endlos99/finalgrom99/doc/manual.html

# FinalGROM 99

The TI 99/4A FinalGROM Cartridge, or FinalGROM 99 for short, is a cartridge for the TI 99/4A home computer that allows you to run ROM and GROM cartridge images from an SD card. It succeeds the FlashROM 99 (https://endlos99.github.io/flashrom99) released in 2016.

The FinalGROM 99 Cartridge

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

Mounted in Cartridge Shell

The FinalGROM 99 is released as Open Source Hardware under the CERN OHL license (http://www.ohwr.org/projects/cernohl/wiki) and the GNU GPL license (http://www.gnu.org/licenses/gpl.html). Both hardware design files and firmware sources are available on GitHub (https://github.com/endlos99/finalgrom99).

The project homepage with detailed instructions is located at GitHub (https://endlos99.github.io/finalgrom99).

## How to Start with the FinalGROM 99

Using the FinalGROM 99 is simple and doesn't require any special hardware or software.

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

Image selection

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

## How to Prepare the FinalGROM 99

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

### Images

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

helloc.bin   <-
hellod.bin   <-  the image files
hellog.bin   <-
layout.xml
meta-inf.xml

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

Finally, many assemblers such as the xas99 cross-assembler or the xga99 GPL cross-assembler from the xdt99 tools (https://endlos99.github.io/xdt99) can generate ROM and GROM images. Files generated for Editor/Assembler Option #5 cannot be used, but they may be converted for the FinalGROM 99 plus 32K RAM expansion.

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

The FinalGROM 99 uses "non-inverted" ROM images, which is the default for images until noted otherwise by the creator. Images ending in 3 or 9 are usually inverted. If you have an inverted ROM image, you can use the Python script tools/invert.py found in the repository (https://github.com/endlos99/finalgrom99) to de-invert the image. If a single file ROM image crashes the TI 99, invert it and see if that works instead.

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

### Filenames

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

A GROM-only image is always a single file whose filename ends in G:

hellog.bin

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

helloc.bin
hellod.bin   (optional)
hellog.bin

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

The split file format has been used for virtually all cartridge dumps for several decades now.

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

In summary, don't rename cartridge dumps. GROM filenames must not exceed 8 characters AND must end in G. ROM filename must have more than 8 characters OR must not end in D or G.

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

### SD Cards

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

### Tools

The tools/ folder in the repository (https://github.com/endlos99/finalgrom99) contains some Python scripts that help you to manage your images.

The showcart.py tool will list the menu entries for the image files given.

Example: showcart.py images/*.bin

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

Example: invert.py image.bin

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

Examples: pad.py image.bin pad.py largeimage.bin 65536

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

Example: mkea5cart.py program1 theprogram.bin "THE PROGRAM"

## How to Use the FinalGROM 99

This section details the operation of the FinalGROM 99 and explains all of its features.

### Normal Operation

The FinalGROM 99 is always in one of two modes: menu mode or image mode.

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

It is not possible to damage the FinalGROM 99 by incorrect menu or image operation.

### Help Viewer

The FinalGROM 99 allows you to view image help texts stored on the SD card.

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

To return to the FinalGROM 99 menu, press Q to quit the help viewer.

If no help text is found, you'll return immediately to the FinalGROM menu.

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

The first line of your help file may contain a hexadecimal color code for the text

    >1E

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

### Advanced Modes

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

aorg >6000
data >aa01
byte >00, 'R'  ; activate RAM mode

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

### Compatibility

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

Please refer to the troubleshooting section for a list of programs with known issues.

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

## How to Develop for the FinalGROM 99

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

### Advanced Modes

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

move 10, g@data, g@>7800

and alike would be the only way to write to GRAM.

### Reloading

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

The repository (https://github.com/endlos99/finalgrom99) contains sample code lib/reload_example.a99 and lib/gload_example.gpl that may serve developers as a blueprint for reloading. The syntax requires the xas99 or xga99 assemblers (https://endlos99.github.io/xdt99), but the code is easily adapted to other assemblers as well.

### Dumping

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

The repository (https://github.com/endlos99/finalgrom99) contains sample code lib/dump_example.a99 and lib/gdump_example.gpl that may serve developers as a blueprint for dumping. The syntax requires the xas99 and xga99 assemblers (https://endlos99.github.io/xdt99), but the code is easily adapted to other assemblers as well.

## How the FinalGROM 99 Works

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

The microcontroller uses a modified version of the Petit FatFs (http://elm-chan.org/fsw/ff/00index_p.html) library to make sense of the FAT16/FAT32 filesystems used by SD cards. It also uses a port of the Xilinx XSVF player described in Application Note 058 (http://www.xilinx.com/support/documentation/application_notes/xapp058.pdf).

## How to Update the FinalGROM 99

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

#U1  (o)........(o).........(o)........(o)........(o)........(o) ...

indicates a bad SD card reader, a bad SD card, or the wrong filesystem,

#U2  (o).(o)........(o).(o).........(o).(o)........(o).(o)...... ...

indicates a missing or corrupt update file.

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

### Update 1.1

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

Download 1.1

### Update 1.2

Issues: - None

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

Download 1.2

### Update 1.3

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

This update fixes this issue, while still auto-loading single images with only subprograms.

Download 1.3

## Troubleshooting the FinalGROM 99

If you're in doubt if your FinalGROM 99 is working correctly, run the cartridge tests in folder images/tests/ in the repository (https://github.com/endlos99/finalgrom99). All tests run endlessly and will show errors as ERROR xxxx yyyy at the bottom of the screen. The hex value xxxx is the expected word and yyyy is the actual word read.

#### The LED blinks.

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

#1  (o)........(o).........(o)........(o)........(o)........(o) ...

indicates a bad SD card reader, a bad SD card, or the wrong filesystem,

#2  (o).(o)........(o).(o).........(o).(o)........(o).(o)...... ...

indicates the root folder cannot be read, or the image cannot be dumped,

#3  (o).(o).(o)........(o).(o).(o).........(o).(o).(o)......... ...

indicates a corrupt image, a corrupt help file, or an error during dumping.

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

#### The TI 99 title screen won't show.

The LED lights for some time, but the TI title screen won't show.

The FinalGROM 99 is active, but it interferes with the console GROMs.

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

#### There is no FinalGROM 99 entry.

The TI 99 starts normally, but the menu shows only TI BASIC.

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

#### Some menu entry is missing.

The menu entry of some image, in particular some educational title, is missing.

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

Check the filename of your image, and look for that filename in the image browser.

#### The image browser shows weird entries.

The image browser shows meaningless entries such as DEUTSCH or ITALIANO.

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

If you don't know which image is producing these rogue entries, you can use the tools/showcart.py script in the repository (https://github.com/endlos99/finalgrom99) like this:

$ showcart.py phm3112C.BIN phm3112G.BIN

to get the list of entries for the specified list of programs:

phm3112C.BIN: **MISSING >AA**
phm3112G.BIN: PARSEC

#### The image browser crashes.

The images browser shows weird characters and does no longer react to key presses.

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

#### Some program crashes.

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

#### Some program doesn't work properly.

Some functionality of the program doesn't work as expected.

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

#### RAM/GRAM cannot be written to.

The program cannot write to the RAM banks or the GRAM banks.

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

#### Mini Memory won't work.

The Mini Memory won't save assembly programs.

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

#### Programs with known issues.

These programs are know to have minor or major flaws when run on the FinalGROM 99:

- As of this writing, no issues or glitches are known.

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

## Where to Get the FinalGROM 99

The GitHub repository (https://github.com/endlos99/finalgrom99) contains all hardware design files and software sources required to build the FinalGROM 99 by yourself.

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

## About the Project

The TI 99/4A FinalGROM Cartridge is Open Source Hardware released under the CERN OHL license (http://www.ohwr.org/projects/cernohl/wiki), in the hope that TI 99 enthusiasts may find it useful. Software components are released under the GNU GPL license (http://www.gnu.org/licenses/gpl.html).

The hardware was designed with the open source electronics design automation suite KiCad (http://kicad-pcb.org). The microcontroller code uses a modified version of the Petit FatFs (http://elm-chan.org/fsw/ff/00index_p.html) library.

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

Contributions to both hardware and software are welcome. Please email feedback, support questions, inquiries for parts, and bug reports to the developer at r@0x01.de. Discussions about the FinalGROM 99 happen over at AtariAge (http://atariage.com/forums/topic/260917-the-finalgrom-99).
