endlos99/finalgrom99/(threads)

Thread 1 (2019-01-08):

4A DOS w/Auto-start+CHARA1 companion GROM doesn't load GROM image

jedimatt42, 2019-01-08:
Given a GROM file that has a header of:

0xAA00 0x0000 0x6010 0x0000
where 0x6010 is a powerup routine in the GROM.  and a ROM image with a standard ROM header... such as that of 4A DOS, with one or two program entries...
FG99 does not create a menu entry for the GROM even though 4A's boot rom qualifies it as a valid GROM header with a powerup routine.  FG99 does create a menu entry for the ROM file...

When loading the file from a menu entry, it looks like if it starts with a GROM, then it will load companion ROM files C and D, but if it starts with a ROM, it never looks for a companion G.BIN to load.

I was able to work around this by adding a menu entry to my GROM so it would become the 'master' file for the entry.

-M@

endlos99, 2019-01-15:
Thanks for reporting this issue!

As you said, if no entries are found in the `G` file, the FinalGROM ignores this file entirely.  This holds true for any file.  But there's some logic that when an entry of a file that ends in `G` is selected, the files `G`, `C`, and `D` are loaded, if they exist.  If the entry is in a `C` file, then only `C` and `D` are loaded, since there is no `G` file in general.

The solution to this problem would be to try to load a `G` file when selecting an entry in a `C` file.  This seems easy enough, but the problem is that for every "open" in the code, the microcontroller has to scan the entire directory for a file with the requested name.  This time is noticeable if the directory is near its limit of 171 entries -- I've tested it.

Now if this were a common pattern, I could still add the extra load as there would be a real benefit.  In this case, however, 4A DOS seems to be the only program known to be affected, and there is a known workaround.

So unless this problem rises again, I'll keep the current logic.

Closed 2019-01-15.

Thread 5 (2023-08-04):

Sub folders not loading

ghhann, 2023-08-04:
Weird issue. On a beige ti.  I insert the finalgrom and see it as 2 on the menu. I press 2 and get your submenus a b c and so forth.  When I press any submenu. I get a weird screen blip and then no items shown.

I redid the sd card and not working.  I can access the directories on my PC.

Any place to start troubleshooting?

Best

ghhann, 2023-08-04:
Never mind appearantly I have a qi motherboard.

ghhann, 2023-08-04:
Thank you

ghhann, 2023-08-08:
Thanks very much appreciated your hard work and efforts to this project Sent via the Samsung Galaxy A52 5G, an AT&T 5G smartphone
-------- Original message --------From: Ralph Benzinger ***@***.***> Date: 8/8/23  11:08 AM  (GMT-05:00) To: endlos99/finalgrom99 ***@***.***> Cc: ghhann ***@***.***>, Author ***@***.***> Subject: Re: [endlos99/finalgrom99] Sub folders not loading (Issue #5)
There is a firmware for QI machines available, but I've just realized that it isn't published in the repo.  Let me find it, then I can include it here as well.

—Reply to this email directly, view it on GitHub, or unsubscribe.You are receiving this because you authored the thread.Message ID: ***@***.***>

ghhann, 2023-08-11:
Not to bother you but I was wondering if you found the updated firmware for the qi models.I actually just finished another ti99/4a so I have a beige qi model that is now clean and functioning and a black/chrome model which is also clean and functional.Been enjoying seeing what these can do since I never had one in the 80's.All my best and thank you for your help and work and efforts in developing these expansion cartridges....Dr Glenn Hann PhD Sent via the Samsung Galaxy A52 5G, an AT&T 5G smartphone
-------- Original message --------From: ghhann ***@***.***> Date: 8/8/23  11:58 AM  (GMT-05:00) To: endlos99/finalgrom99 ***@***.***>, endlos99/finalgrom99 ***@***.***> Cc: Author ***@***.***> Subject: Re: [endlos99/finalgrom99] Sub folders not loading (Issue #5) Thanks very much appreciated your hard work and efforts to this project Sent via the Samsung Galaxy A52 5G, an AT&T 5G smartphone-------- Original message --------From: Ralph Benzinger ***@***.***> Date: 8/8/23  11:08 AM  (GMT-05:00) To: endlos99/finalgrom99 ***@***.***> Cc: ghhann ***@***.***>, Author ***@***.***> Subject: Re: [endlos99/finalgrom99] Sub folders not loading (Issue #5)
There is a firmware for QI machines available, but I've just realized that it isn't published in the repo.  Let me find it, then I can include it here as well.

—Reply to this email directly, view it on GitHub, or unsubscribe.You are receiving this because you authored the thread.Message ID: ***@***.***>

endlos99, 2023-08-12:
I've added both update files to the updates/ folder in the repo.  I think the update will work on a QI machine, assuming you have the non-QI firmware installed.  The upgrade process is described in the manual:
https://endlos99.github.io/finalgrom99/

For a discussion about the QI firmware (which was created not by me but by Jochen Buur) see here:
https://forums.atariage.com/topic/322211-modify-qi-console-for-finalgrom99-use/

I don't think you'll need to modify your cart, but check that discussion if you still have any problems after the upgrade.

ghhann, 2023-09-12:
Ralph,

Hope all is well......was improving on my recovery and I might have bricked my finalgrom99 in loading the qi firmware and uodate.avr.

Getting no response...would it be possible to ship you the board to determine if it is a simple refresh to fix or the board is toast knowing that you don't have a qi if you could restore to v1.3.  Then I'll just use it on a black and metal unit instead of the beige.  If not maybe you can salvage some parts off the board and I can acquire a new one. Let me know either way if it's something you can do or not.  I know I'm asking for a Hugh favor here.  My email is glennhann@comcast.net

Thanks

Glenn

Closed 2023-08-12.

Thread 8 (2025-09-21):

The XC95144XL-TQ100 is no longer available

SergeantOsborne, 2025-09-21:
The XC95144XL-TQ100 is no longer available, my research suggest the XC95144XL-7TQG100I or the XC95144XL-10TQ100I should be pin compatible.  Do you have other recommendations for this CPLD?
