endlos99/finalgrom99/pcb/fg99.kicad_pcb

## KiCad design pcb/fg99.kicad_pcb (2017-07-09)

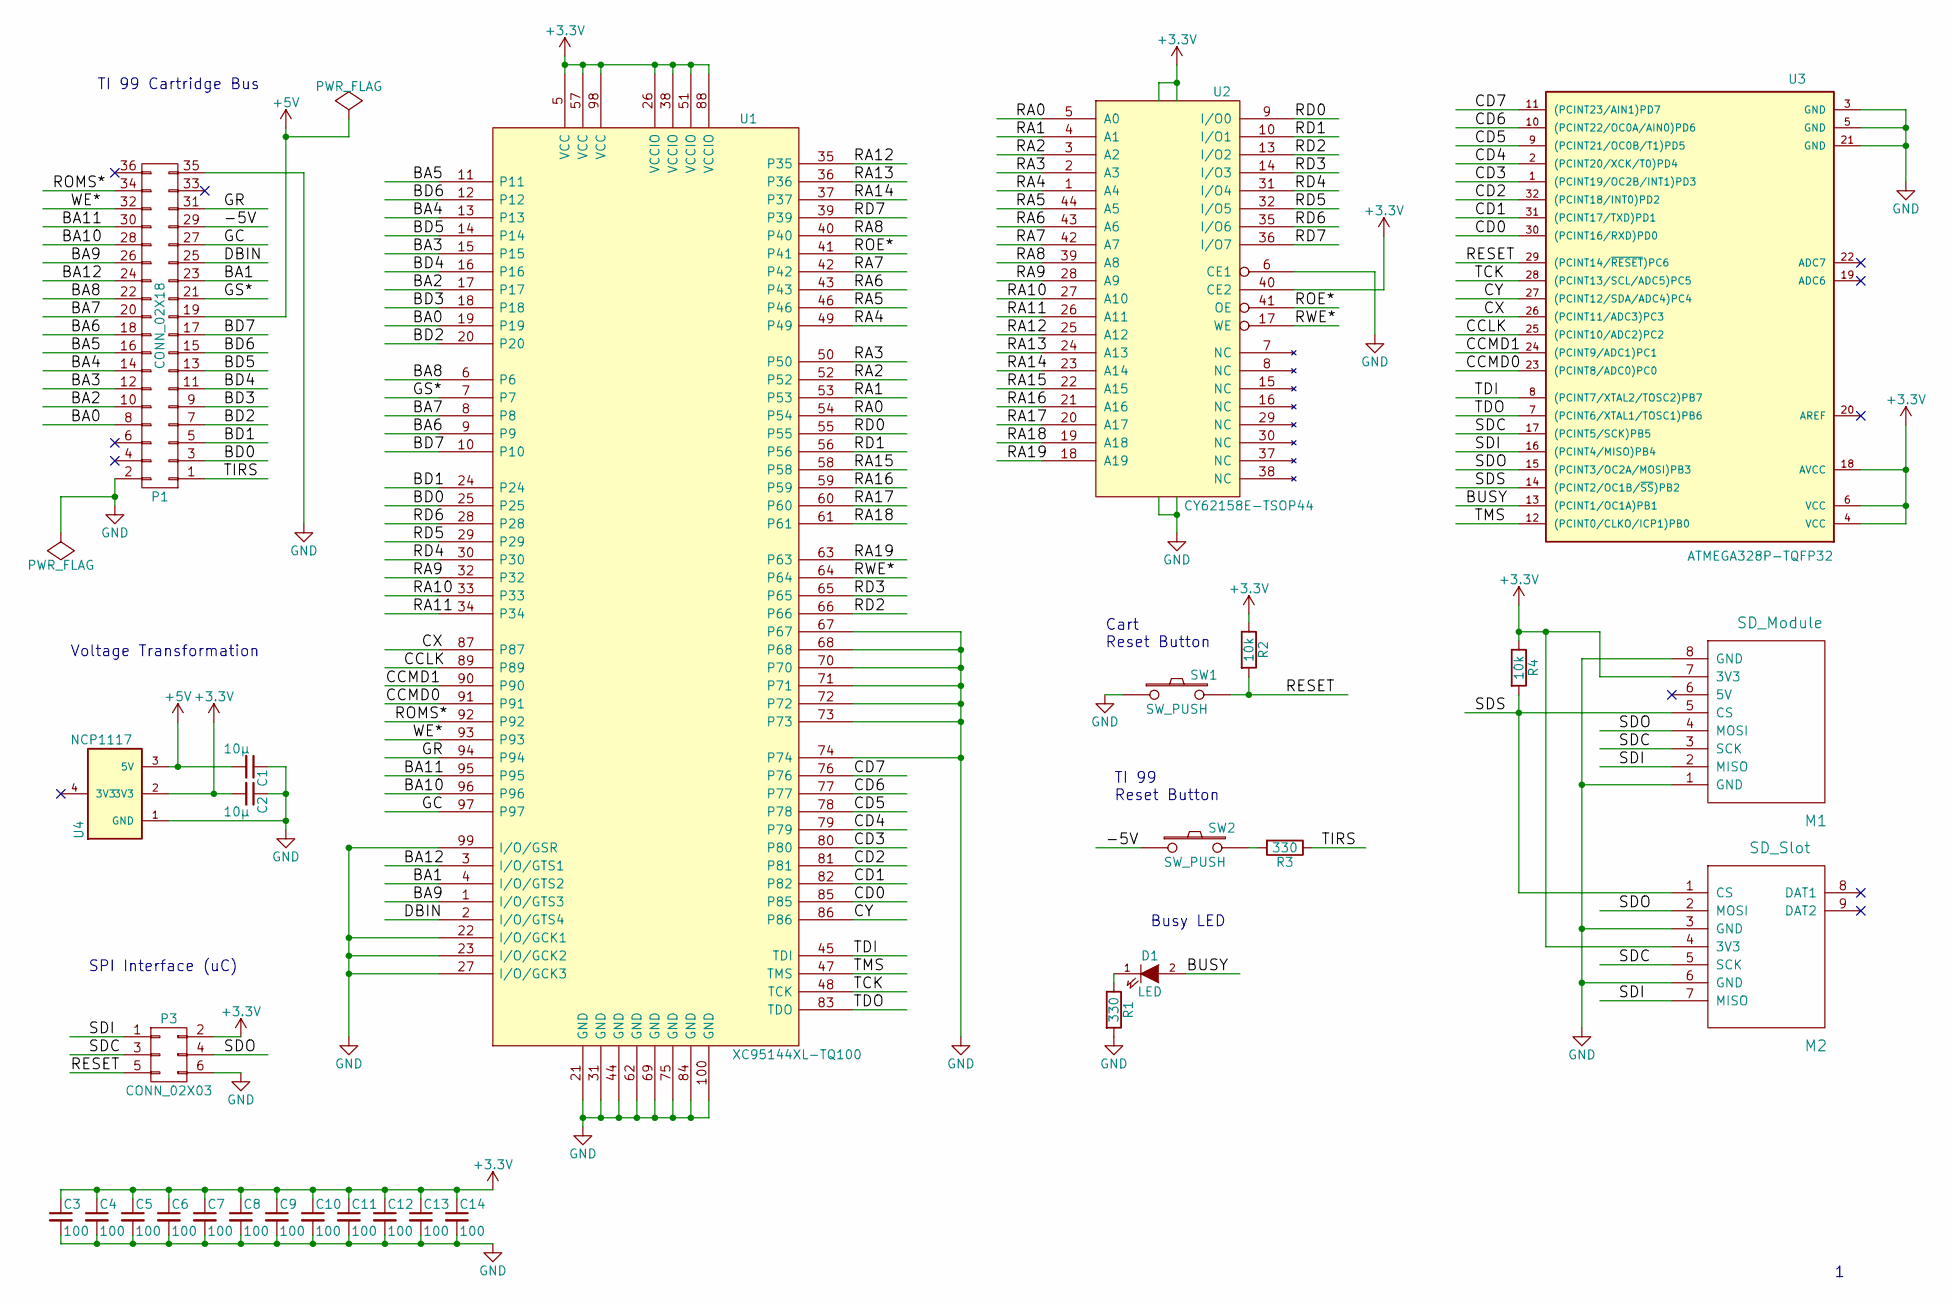
[picture p6: schematic fg99.sch, FinalGROM 99]

Parts:
C1, C2: 10µ; TantalC_SizeA_EIA-3216_Reflow; MFG Part No TAJA106K016RNJ
C3, C4, C5, C6, C7, C8, C9, C10, C11, C12, C13, C14: 100; C_0603; MFG Part No RND1500603B104J250
D1: LED; LED-5MM
M1: SD_Module; SD_MODULE_REV
M2: SD_Slot; SD-SOCKET
P1: CONN_02X18; CART_BUS
P3: CONN_02X03; IDC_Header_Straight_6pins
R1: 330; R_0603_T; MFG Part No RC0603FR-07330RL
R2, R4: 10k; R_0603_T; MFG Part No RC0603FR-0710KL
R3: 330; R_0603_T; MFG Part No RC0603FR-0710KL
SW1, SW2: SW_PUSH; SW_PUSH_6mm
U1: XC95144XL-TQ100; TQFP-100_14x14mm_Pitch0.5mm; MFG Part No XC95144XL-10TQG100C
U2: CY62158E-TSOP44; TSOP-44; MFG Part No CY62158ELL-45ZSXIT
U3: ATMEGA328P-TQFP32; TQFP-32_7x7mm_Pitch0.8mm; MFG Part No ATMEGA328P-AU
U4: NCP1117; SOT-223; MFG Part No NCP1117ST33T3G

Connections:
+3V3: C2.2, C3.1, C4.1, C5.1, C6.1, C7.1, C8.1, C9.1, C10.1, C11.1, C12.1, C13.1, C14.1, M1.7 (3V3), M2.4 (3V3), P3.2, R2.1, R4.1, U1.5 (VCC), U1.26 (VCCIO), U1.38 (VCCIO), U1.51 (VCCIO), U1.57 (VCC), U1.88 (VCCIO), U1.98 (VCC), U2.11 (VCC), U2.33 (VCC), U2.40 (CE2), U3.4 (VCC), U3.6 (VCC), U3.18 (AVCC), U4.2 (3V3)
+5V: C1.2, P1.19, U4.3 (5V)
/-5V: P1.29, SW2.1
/BA0: P1.8, U1.19
/BA1: P1.23, U1.4 (I/O/GTS2)
/BA2: P1.10, U1.17
/BA3: P1.12, U1.15
/BA4: P1.14, U1.13
/BA5: P1.16, U1.11
/BA6: P1.18, U1.9
/BA7: P1.20, U1.8
/BA8: P1.22, U1.6
/BA9: P1.26, U1.1 (I/O/GTS3)
/BA10: P1.28, U1.96
/BA11: P1.30, U1.95
/BA12: P1.24, U1.3 (I/O/GTS1)
/BD0: P1.3, U1.25
/BD1: P1.5, U1.24
/BD2: P1.7, U1.20
/BD3: P1.9, U1.18
/BD4: P1.11, U1.16
/BD5: P1.13, U1.14
/BD6: P1.15, U1.12
/BD7: P1.17, U1.10
/BUSY: D1.2 (A), U3.13 ((PCINT1/OC1A)PB1)
/CCLK: U1.89, U3.25 ((PCINT10/ADC2)PC2)
/CCMD0: U1.91, U3.23 ((PCINT8/ADC0)PC0)
/CCMD1: U1.90, U3.24 ((PCINT9/ADC1)PC1)
/CD0: U1.85, U3.30 ((PCINT16/RXD)PD0)
/CD1: U1.82, U3.31 ((PCINT17/TXD)PD1)
/CD2: U1.81, U3.32 ((PCINT18/INT0)PD2)
/CD3: U1.80, U3.1 ((PCINT19/OC2B/INT1)PD3)
/CD4: U1.79, U3.2 ((PCINT20/XCK/T0)PD4)
/CD5: U1.78, U3.9 ((PCINT21/OC0B/T1)PD5)
/CD6: U1.77, U3.10 ((PCINT22/OC0A/AIN0)PD6)
/CD7: U1.76, U3.11 ((PCINT23/AIN1)PD7)
/CX: U1.87, U3.26 ((PCINT11/ADC3)PC3)
/CY: U1.86, U3.27 ((PCINT12/SDA/ADC4)PC4)
/DBIN: P1.25, U1.2 (I/O/GTS4)
/GC: P1.27, U1.97
/GR: P1.31, U1.94
/GS*: P1.21, U1.7
/RA0: U1.54, U2.5 (A0)
/RA1: U1.53, U2.4 (A1)
/RA2: U1.52, U2.3 (A2)
/RA3: U1.50, U2.2 (A3)
/RA4: U1.49, U2.1 (A4)
/RA5: U1.46, U2.44 (A5)
/RA6: U1.43, U2.43 (A6)
/RA7: U1.42, U2.42 (A7)
/RA8: U1.40, U2.39 (A8)
/RA9: U1.32, U2.28 (A9)
/RA10: U1.33, U2.27 (A10)
/RA11: U1.34, U2.26 (A11)
/RA12: U1.35, U2.25 (A12)
/RA13: U1.36, U2.24 (A13)
/RA14: U1.37, U2.23 (A14)
/RA15: U1.58, U2.22 (A15)
/RA16: U1.59, U2.21 (A16)
/RA17: U1.60, U2.20 (A17)
/RA18: U1.61, U2.19 (A18)
/RA19: U1.63, U2.18 (A19)
/RD0: U1.55, U2.9 (I/O0)
/RD1: U1.56, U2.10 (I/O1)
/RD2: U1.66, U2.13 (I/O2)
/RD3: U1.65, U2.14 (I/O3)
/RD4: U1.30, U2.31 (I/O4)
/RD5: U1.29, U2.32 (I/O5)
/RD6: U1.28, U2.35 (I/O6)
/RD7: U1.39, U2.36 (I/O7)
/RESET: P3.5, R2.2, SW1.2, U3.29 ((PCINT14/~RESET~)PC6)
/ROE*: U1.41, U2.41 (OE)
/ROMS*: P1.34, U1.92
/RWE*: U1.64, U2.17 (WE)
/SDC: M1.3 (SCK), M2.5 (SCK), P3.3, U3.17 ((PCINT5/SCK)PB5)
/SDI: M1.2 (MISO), M2.7 (MISO), P3.1, U3.16 ((PCINT4/MISO)PB4)
/SDO: M1.4 (MOSI), M2.2 (MOSI), P3.4, U3.15 ((PCINT3/OC2A/MOSI)PB3)
/SDS: M1.5 (CS), M2.1 (CS), R4.2, U3.14 ((PCINT2/OC1B/~SS~)PB2)
/TCK: U1.48 (TCK), U3.28 ((PCINT13/SCL/ADC5)PC5)
/TDI: U1.45 (TDI), U3.8 ((PCINT7/XTAL2/TOSC2)PB7)
/TDO: U1.83 (TDO), U3.7 ((PCINT6/XTAL1/TOSC1)PB6)
/TIRS: P1.1, R3.1
/TMS: U1.47 (TMS), U3.12 ((PCINT0/CLKO/ICP1)PB0)
/WE*: P1.32, U1.93
GND: C1.1, C2.1, C3.2, C4.2, C5.2, C6.2, C7.2, C8.2, C9.2, C10.2, C11.2, C12.2, C13.2, C14.2, M1.1 (GND), M1.8 (GND), M2.3 (GND), M2.6 (GND), P1.2, P1.35, P3.6, R1.2, SW1.1, U1.21 (GND), U1.22 (I/O/GCK1), U1.23 (I/O/GCK2), U1.27 (I/O/GCK3), U1.31 (GND), U1.44 (GND), U1.62 (GND), U1.67, U1.68, U1.69 (GND), U1.70, U1.71, U1.72, U1.73, U1.74, U1.75 (GND), U1.84 (GND), U1.99 (I/O/GSR), U1.100 (GND), U2.6 (CE1), U2.12 (GND), U2.34 (GND), U3.3 (GND), U3.5 (GND), U3.21 (GND), U4.1 (GND)
unnamed: D1.1 (K), R1.1
unnamed: R3.2, SW2.2

Notes on the sheet:
Voltage Transformation
TI 99 Reset Button
Busy LED
TI 99 Cartridge Bus
SPI Interface (uC)
Cart Reset Button

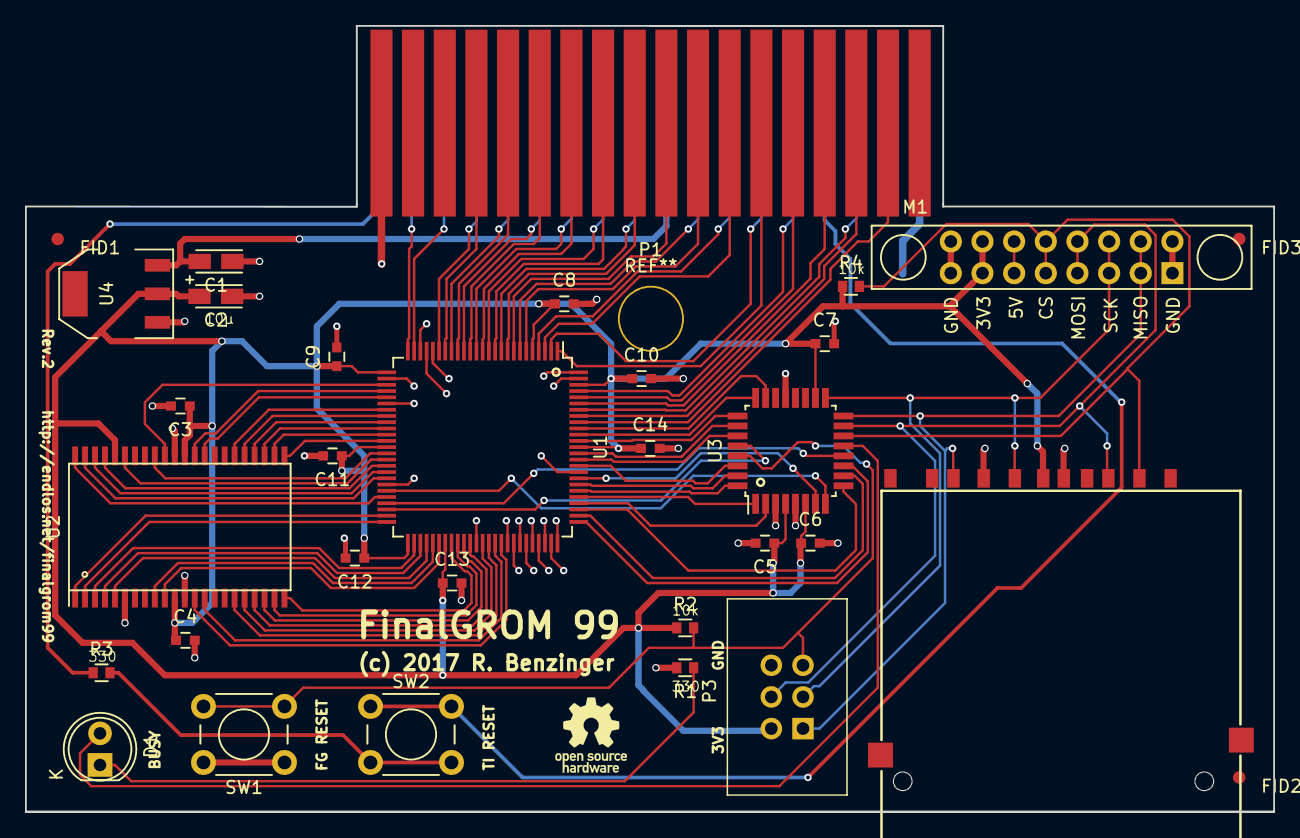
[picture p7: board fg99.kicad_pcb from above]

Board: 2 copper layers, 100.1 x 63.1 mm, 32 parts (0 on the bottom side), 87 nets.

Other parts of the board:
FID1, FID2, FID3: Fiducial_1mm_Dia_2.54mm_Outer_CopperTop
