endlos99/finalgrom99/avr/finalgrom.c

/*
 * FinalGROM 99
 *
 * A cartridge for the TI 99 that allows for running ROM and GROM images
 * stored on an SD card
 *
 * Copyright (c) 2017 Ralph Benzinger <r@0x01.de>
 *
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
 * You should have received a copy of the GNU General Public License
 * along with this program; if not, see <http://www.gnu.org/licenses/>.
 */


#include <stdint.h>

#include "loader.h"


extern uint8_t selection[];


int main(void)
{
  uint8_t regen = 1;
  uint8_t sel = SEL_PROGRAM;

  // setup cart
  setup();

  while (1) {
    // create menu loader
    if (regen && genMenu())
      break;  // load single image immediately
    // wait for image selection
    sel = selectImage(0);
    if (sel == SEL_PROGRAM)
      break;  // load program
    else if (sel == SEL_HELP)
      regen = loadHelp();  // show help file
    else
      regen = changeDir();  // cd into selected folder
  }

  // load selected image, and wait for potential reload or dump
  while (1) {
    if (sel == SEL_DUMP)
      dumpImage();
    else
      loadImage();
    sel = selectImage(1);
  }
}
