endlos99/finalgrom99/(commit log)

2017-07-09 FinalGROM 99 release
    [dump_test.txt, fg99.kicad_pcb, fg99.sch]
2017-07-29 fix slow SD cards, release update 1.1
    [loader.c]
2017-11-24 add missing code changes for version 1.2
    [loader.c]
2019-10-28 remove remaining latch (to fix Minimem bug)
    [basic.vhdl]
2021-11-09 Update README.md
    https://forum.kicad.info/t/warning-avoid-all-links-to-kicad-pcb-org-use-kicad-org/31521
2023-08-19 Add Gerber files for PCB
    [fg99-B_Cu.gbl, fg99-B_Mask.gbs, fg99-Edge_Cuts.gm1, fg99-F_Cu.gtl, fg99-F_Mask.gts, fg99-F_Paste.gtp, fg99-F_SilkS.gto, fg99.gbl]
