endlos99/finalgrom99/(notices)

Notices in the files:
pcb/fg99.kicad_pcb:
Released as Open Source Hardware under CERN OHL 1.2 and GNU GPL 3 licenses
(c) 2017 R. Benzinger
